ma-ath/Amplificador-de-Potencia/README.md

# Amplificador-de-Potencia
Trabalho Final de Eletrônica IV - Amplificador de Potência

エレクトロニクス4期末宿題、パワー増幅器
