ma-ath/Amplificador-de-Potencia/Proposta de Trabalho.pdf

### Proposta de Trabalho

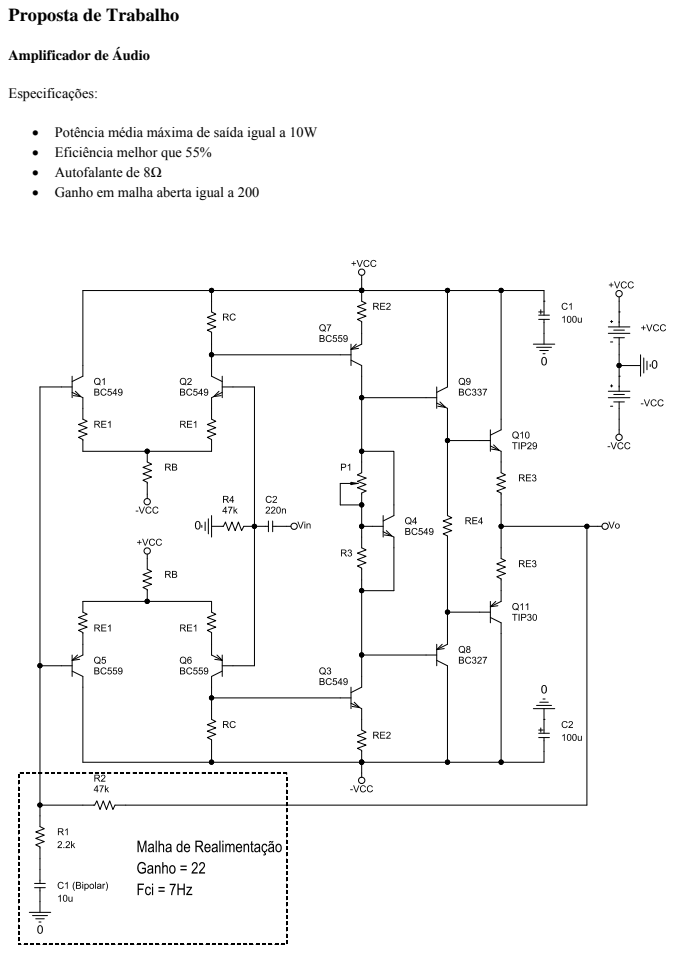
[picture p1: page 1]
Especificações:

Amplificador de Áudio

• Potência média máxima de saída igual a 10W
• Eficiência melhor que 55%
• Autofalante de 8Ω
• Ganho em malha aberta igual a 200

### Análise do Circuito

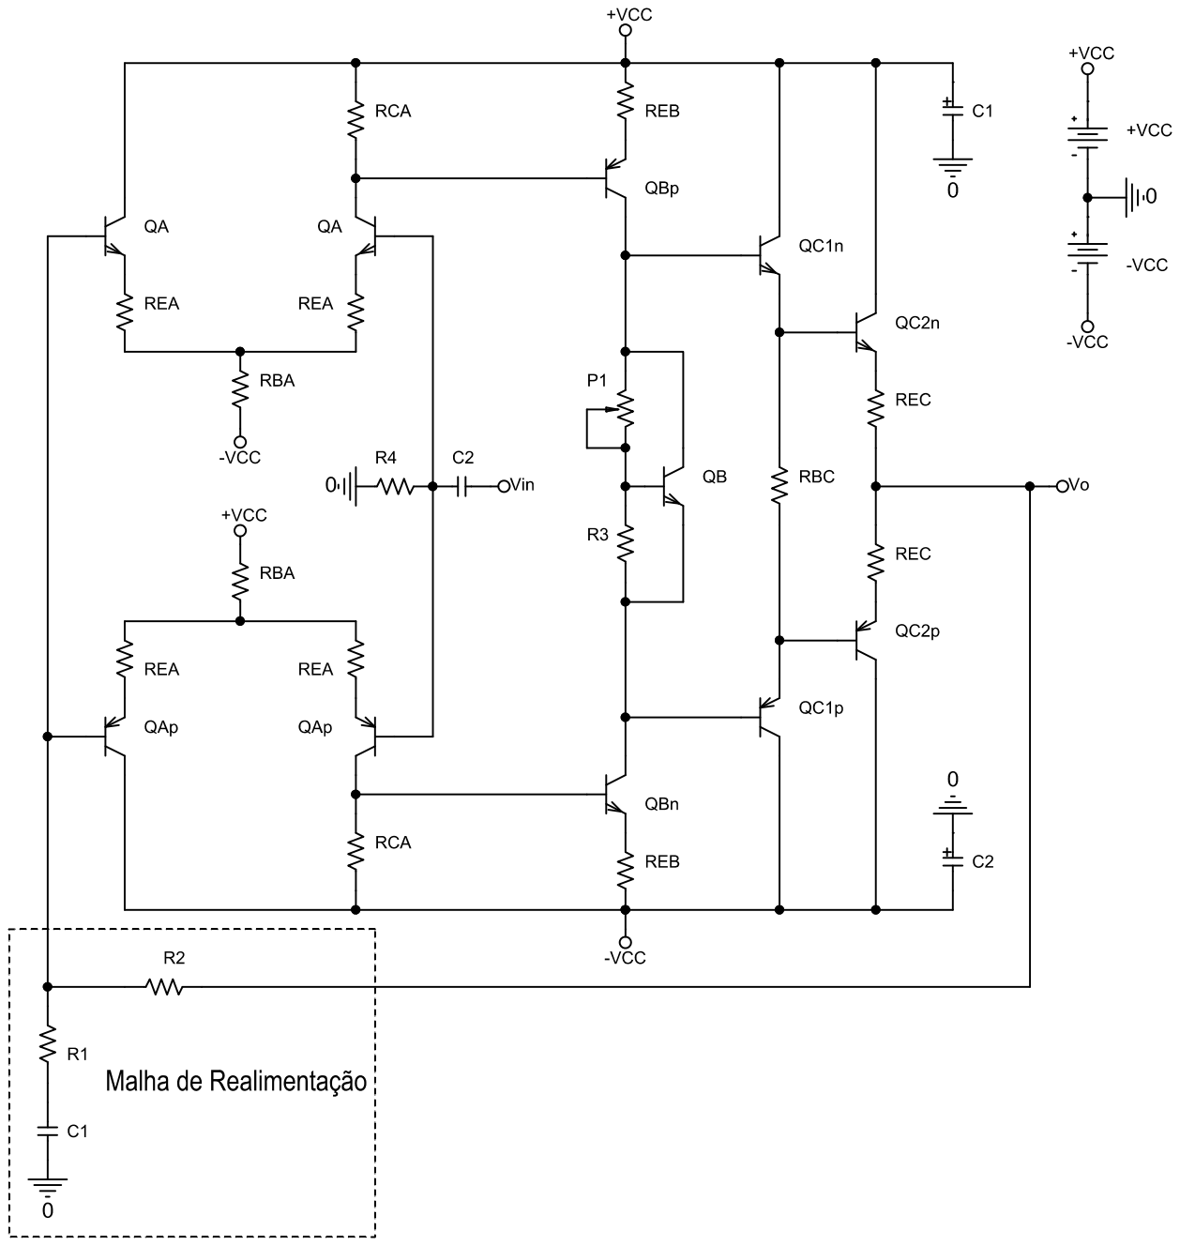
[picture p2: figure]

Figura 1: Amplificador de potência.

Inicialmente vamos separar o circuito em 3 blocos básicos: A, estágio de entrada; B, estágio intermediário; C, estágio de saída. O estágio de saída é um push-pull com transistores em configuração Darlington. Se considerarmos
REC | L R e o ganho aproximadamente igual a 1, podemos representa-lo como uma carga equivalente para o
estágio B; com valor RCeq | C | C | L = | + | + (β | β 1 | 2 1 | 1 )( | ) R , onde βC1 e βC2 são os ganhos de corrente dos transistores. Desta

forma, temos o circuito simplificado da Fig.3. Note que Vq é a tensão VBEq equivalente da configuração Darlington (a soma dos VBEs dos transistores). O ganho de tensão em malha aberta é dado pela multiplicação dos ganhos de cada estágio. Como o ganho de tensão do estágio de saída é aproximadamente igual a 1, temos que o ganho total e:

A | AA OL | A B = | (1)

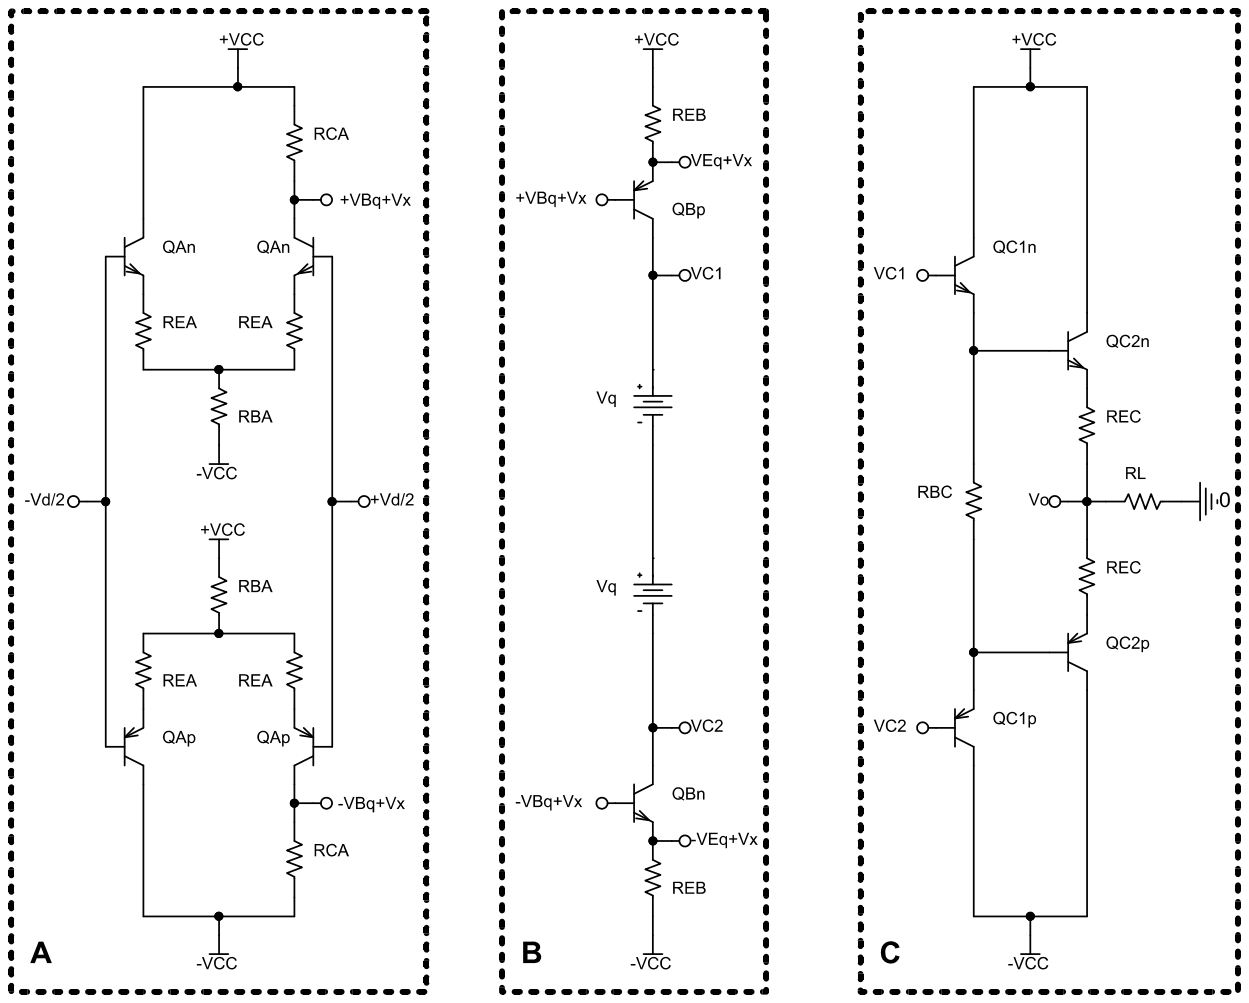
[picture p3: figure]

Figura 2: Amplificador de potência em blocos básicos.

Inicialmente vamos analisar o estágio B. Precisamos saber o valor da tensão de pico na saída V0MAX e a tensão de alimentação VCC. Podemos calcular V0MAX da especificação de potência máxima de saída, ou seja:

0 | 2 V | RP MAX | L LMAX = | (2)

A tensão de alimentação VCC pode ser calculada da especificação de eficiência máxima, ou seja:

0
4

MAX
CC
MAX

V V π
η
≤ | | | | | (3)

Voltando ao estágio B, temos que a tensão AC vx é proveniente da saída do estágio de entrada A. Esta tensão é responsável por gerar a corrente ic e a tensão de saída v0. A tensão AC em cada emissor é aproximadamente igual a
vx e, desta forma, ic pode ser dividida em duas partes iguais, uma para cada coletor, e dada por | 2 c | x | EB i | vR = - | .
Então, temos que:

0

2 Ceq

Ceq c | x | B | x
EB

R
v | R i | v | A | v
R = | =- | =- | (4)

Para estabelecer as condições de polarização adequadas para o funcionamento do circuito, vamos considerar somente a parte superior (o transistor PNP), pois devido à simetria podemos estender o resultado para a parte inferior. Ao passo em que a tensão vx varia, v0 e vC1 variam também. Mas não podemos permitir que a tensão entre emissor e coletor seja menor que VECsat, e nem que a tensão de emissor ultrapasse VCC, pois isto implicaria em uma

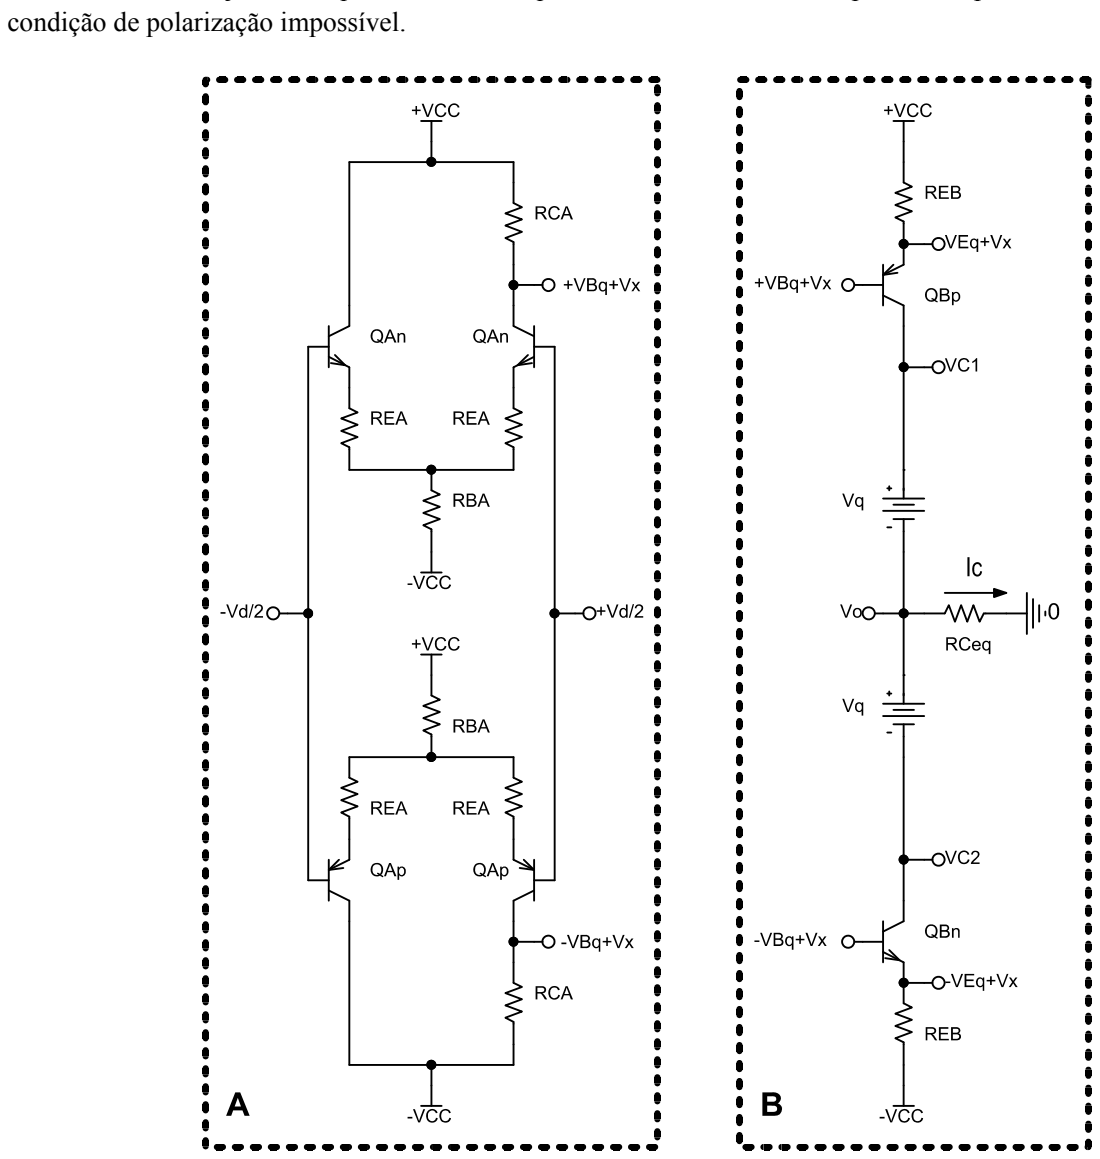
[picture p4: figure]
condição de polarização impossível.

Figura 3: Modelo simplificado.

Por inspeção, verificamos que C | q 1 | 0 v | Vv =+ e a tensão vEC dada por:
EC | Eq | x | C | Eq | x | q 1 | 0 v | V | vv | V | vvV = | +- | = | +-- | (5)

Substituindo (4) em (5), temos que

0
EC | Eq | q 0
B
v v | V | vV
A = | - | -- | (6)

A tensão entre emissor e coletor é mínima quando a tensão de saída v0 é máxima. Substituindo este resultado
em (6), e aplicando a condição EC | ECsat v | V≥ | , temos a inequação:

0

1 1 Eq | ECsat | q | MAX

B

V | V | V | V
A
| æ | ö
≥ | +++ ç | ÷
| è | ø

(7)

Já a tensão de emissor vE é aproximadamente V | v Eq | x + , e | x | 0 | B v | v | A =- | , ou, de forma melhor,
E | Eq | B 0 v | V | v | A = | - | . Notamos que vE é máxima quando v0 é mínima, e o valor mínimo de v0 é -V0MAX . Forçando a
condição E | CC v | V≤ | , temos que

0MAX
Eq CC
B

V V V
A
≤ | - | (8)

Da equação (4) podemos determinar o resistor REB, e das inequações (7) e (8), podemos escolher um valor para VEq dentro do intervalo.

2 Ceq

EB
B

R
R
A = | (9)
Assumindo que EqB | CqB I | I ≈ | , podemos determinar ICqB por:
( | )

2

CC | Eq | CC | Eq | B
CqB
EB | Ceq
V | V | V | V | A
I
R | R
- | - = | = | (10)
Passemos agora para o estágio de entrada A. Por inspeção, temos que V | V | V Bq | Eq | EBq = | - | . Portanto, a diferença de
potencial sobre o resistor RC é V | V | V CC | Eq | EBq - | + | . Neste ponto, temos a liberdade de escolher a corrente de
polarização ICqA dos transistores do estágio A. De posse desta corrente, temos que
CC | Eq | EBq
CA
| CqA
V | V | V
R
| I
- | + = | (11)

Devido à degeneração de emissor nos amplificadores diferenciais, o ganho AA do estágio de entrada é
aproximadamente igual a ( | ) / /( | ( | 1) | 2 RCA | ieB | B | EB | EA - | + | + h | R | R β | , e com este valor podemos calcular o resistor REA, que

é dado por:

/ /( | ( | 1)
2
CA | ieB | B | EB
EA
A
R | h | R R
A
+ β + = | (12)
Considerando EqA | CqA I | I ≈ | , a corrente através de RBA é igual a 2 CqA I , e a diferença de potencial sobre o mesmo
é igual a V | V | RI CC | BEqA | EA CqA - | - | . Temos então que
2 | 2 | 2
CC | BEqA | EA CqA | CC | BEqA | EA
BA
| CqA | | | CqA
V | V | RI | V | V | R R
I | I
- | - | - = | = | - | (13)

Com relação ao estágio de saída, os resistores REC são usados para garantir a estabilidade térmica. Para carga de 8Ω, normalmente usa-se valores entre 0.2Ω e 0.47Ω. O resistor RBC é usado para gerar uma pequena corrente de polarização em QC1n e QC1p, de forma a mantê-los numa região onde os βs estejam próximos do valor máximo. Em geral utiliza-se uma corrente de polarização na ordem de 1mA.

O multiplicador de VBE pode ser dimensionado com base nas equações abaixo, lembrando que neste caso o cálculo de Vq deve ser realizado considerando pouca corrente através dos transistores de saída.

1

3

2 | 1 | B q | BEq
P V | V
R
æ | | ö
=+ ç | ÷ è | ø
(14)

3

1
1 | 1
| 2

B

B

Q

CqB
BEq | q

R
I
V V

β +
æ | ö ç | ÷ -
è | ø
- (15)

3

BEqB

CqB

V
R
I
≥ | (16)

O ganho do amplificador realimentado é definido pela malha de realimentação, e é dado por:

2

1

1 V

R A
R
=+ | (17)

O capacitor C1 é calculado de forma que a frequência de corte seja pelo menos 10 vezes menor que a frequência de corte inferior do amplificador. A resistência que C1 enxerga é R1. O valor de C1 é dado por:

1
1

10

2 CI

C

π f R = | (18)

O resistor R4 é usado para polarizar as bases de QAn e QAp em zero. O capacitor C2 define a frequência de corte inferior, e é dado por:

2
4

1

2 CI

C

π f R = | (19)

Exemplo de Projeto

Como exemplo de projeto, vamos dimensionar um amplificador da Figura 1 com as seguintes especificações:

- Potência média máxima de saída igual a 20W
- Eficiência melhor que 50%
- Autofalante de 8Ω
- Ganho em malha aberta igual a 200
- Ganho de tensão realimentado igual a 18
- Frequência de corte inferior igual a 20Hz

Dados:

- Para os transistores BC549 e BC559, | 200 β = | e | 0.7 V | V BE | = | .
- Para os transistores BC327 e BC337, | 100 β = | , | 0.7 V | V BE | = | e | 0.5 V | V CEsat | ≈ | .
- Para os transistores TIP29 e TIP30, | 15 β = , | 0.7 @ | 10 V | V I | mA BE | C = | ≤ | e | 1@ | 1 V | VI | A BE | C = | ≥ .

Ao desenrolar dos cálculos, os valores dos componentes serão aproximados para os valores comerciais mais próximos.

Das equações (2) e (3), calculamos a tensão de pico na carga e a tensão de alimentação.

0 | 18 V | V MAX =

24 V | V CC =
Vamos adotar ganhos iguais para os estágios A e B, ou seja, | 200 14.1 A | A | A A | B | OL = | = | = | = | .

Segundo os dados do manual dos transistores potência, para corrente de coletor na ordem de 1A, temos
1 V | V BE | ≈ . Para os outros transistores adotaremos | 0.7 V | V BE | ≈ | . As tensões de saturação dos transistores QC1n e QC1p
são | 0.5 V | V CEsat | ≈ | .

Das inequações (7) e (8), determinamos o intervalo de escolha para VEq.

21.5 | 22.7 VV | V ≤ Eq ≤
Vamos adotar | 22 V | V Eq = | . Para RCeq temos RCeq = (100 1 15 1 8 13 + | + | = | Ω )( | ) | k , e pela equação (9) obtemos o

valor de REB.

1.8 REB = kΩ

Como temos a liberdade de atribuir a corrente de polarização do estágio de entrada, adotaremos | 1 CqA I | mA = | , e
pela equação (11) obtemos o valor de RCA.

2.2 RCA = kΩ

Para calcular REA, primeiro precisamos do valor de ICqB que, pela equação (10), é igual a 1.1mA. Com este
valor determinamos hieB pela fórmula | 4.73 ieB | B T | CqB h | VI | k = | = | Ω β | . Assim, pela equação (12), calculamos o valor de
REA.

68 REA = Ω

Da equação (13) obtemos o valor de RBA.

12 RBA = kΩ

O multiplicador de VBE é dimensionado pelas equações (14), (15) e (16). De (16) obtemos 3 R > | Ω 636 e de
(15) obtemos 3 R < | Ω 170k , onde escolhemos 3 R = 3.3kΩ . Finalmente de (14) obtemos 1P | k = | Ω 10 | .

3 R = 3.3kΩ

1P | k | k = | Ω→ | Ω 10 | potenciômetrode 22

Adotando o resistor 1 R = 2.2kΩ sugerido no esquema do amplificador; de (17), calculamos R2 para estabelecer o ganho realimentado de 18.

2 R = 37.4kΩ

Este valor deve ser exato, pois define o ganho realimentado. Pode-se usar um resistor de precisão, uma associação de resistores ou um trimpot.

O resistor RBC é calculado de forma a garantir uma pequena corrente de polarização em QC1n e QC1p, que
adotaremos aproximadamente igual a 1mA. A diferença de potencial sobre RCB é | 2 | 2 | 1.4 BEqC | BEqC n | p V | V | V + | = | . Então
temos | 1.4 1 | 1.4 RCB = | = | Ω m | k , que aproximaremos para o valor comercial mais próximo.

1.5 RCB = kΩ

Finalmente, os capacitores C1 e C2 são calculados pelas equações (18) e (19), assumindo a frequência de corte inferior igual a 20Hz.

1 C | F = 33µ
2 C | nF =180

Resultados de simulação

0 20 @ | 18 P | W | V | V L | MAX = | =
0 0.43% @ | 18 THD | V | V = | = MAX
0 58% @ | 18 η = | = V | V MAX

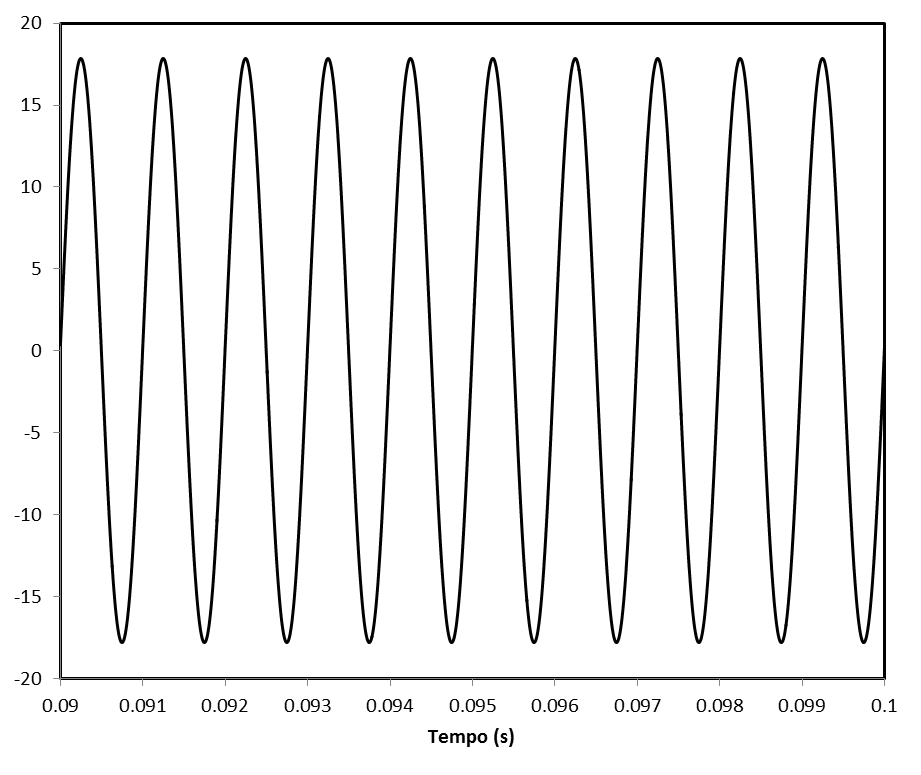
[picture p5: figure]

Figura 4: Gráfico da tensão de saída na frequência de 1kHz e amplitude de 18V.
