ma-ath/Amplificador-de-Potencia/PCB/pronto.pdf

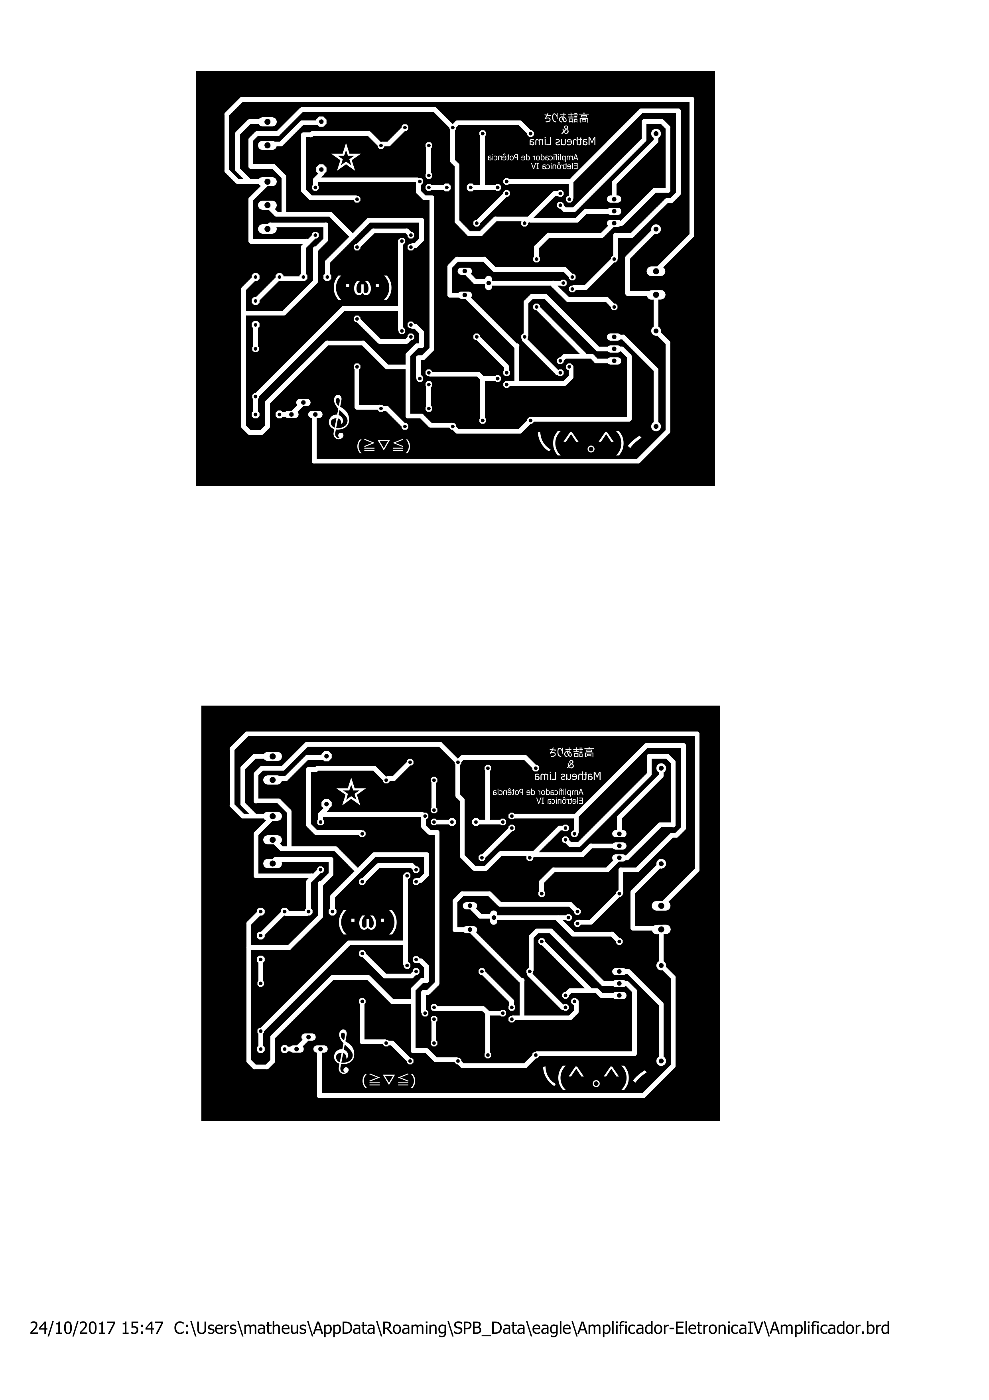
[picture p6: page 1]
