ma-ath/Amplificador-de-Potencia/eletronica-iv-trabalho-PSpiceFiles/Simulações/resposta-frequencia-temperatureSweap.pdf

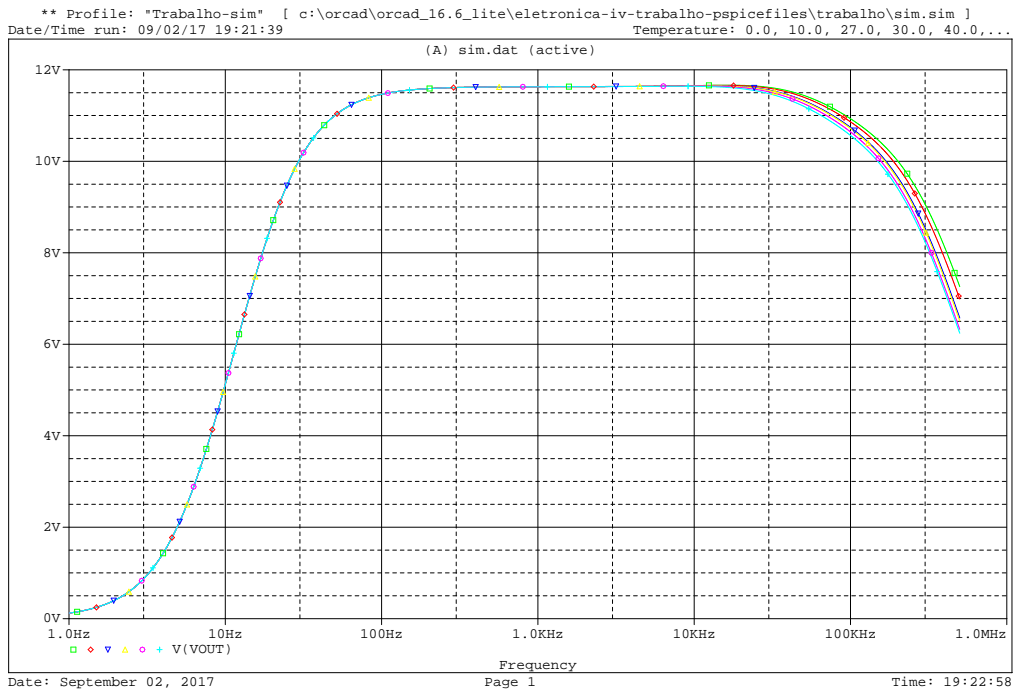
[picture p7: page 1]
Temperature: 0.0, 10.0, 27.0, 30.0, 40.0,...; Date: September 02, 2017; Page 1; Time: 19:22:58; Frequency; 1.0KHz; 10KHz; 100KHz; 1.0MHz; V(VOUT)

** Profile: "Trabalho-sim" [ c:\orcad\orcad_16.6_lite\eletronica-iv-trabalho-pspicefiles\trabalho\sim.sim ]
Date/Time run: 09/02/17 19:21:39

(A) sim.dat (active)
