ma-ath/Amplificador-de-Potencia/eletronica-iv-trabalho-PSpiceFiles/Simulações/resposta-frequencia.pdf

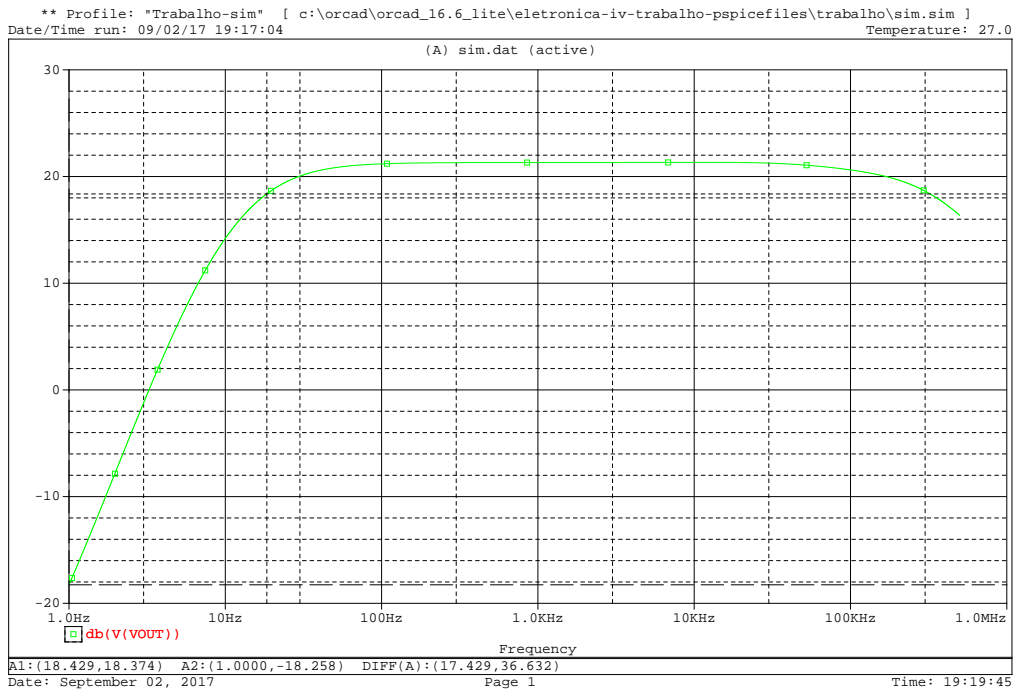
[picture p8: page 1]
A1:(18.429,18.374) A2:(1.0000,-18.258) DIFF(A):(17.429,36.632); Temperature: 27.0; Date: September 02, 2017; Page 1; Time: 19:19:45; Frequency; 1.0KHz; 10KHz; 100KHz; 1.0MHz; db(V(VOUT))

** Profile: "Trabalho-sim" [ c:\orcad\orcad_16.6_lite\eletronica-iv-trabalho-pspicefiles\trabalho\sim.sim ]
Date/Time run: 09/02/17 19:17:04

(A) sim.dat (active)
