ma-ath/Amplificador-de-Potencia/eletronica-iv-trabalho-PSpiceFiles/Simulações/transiente-10w-fourier.pdf

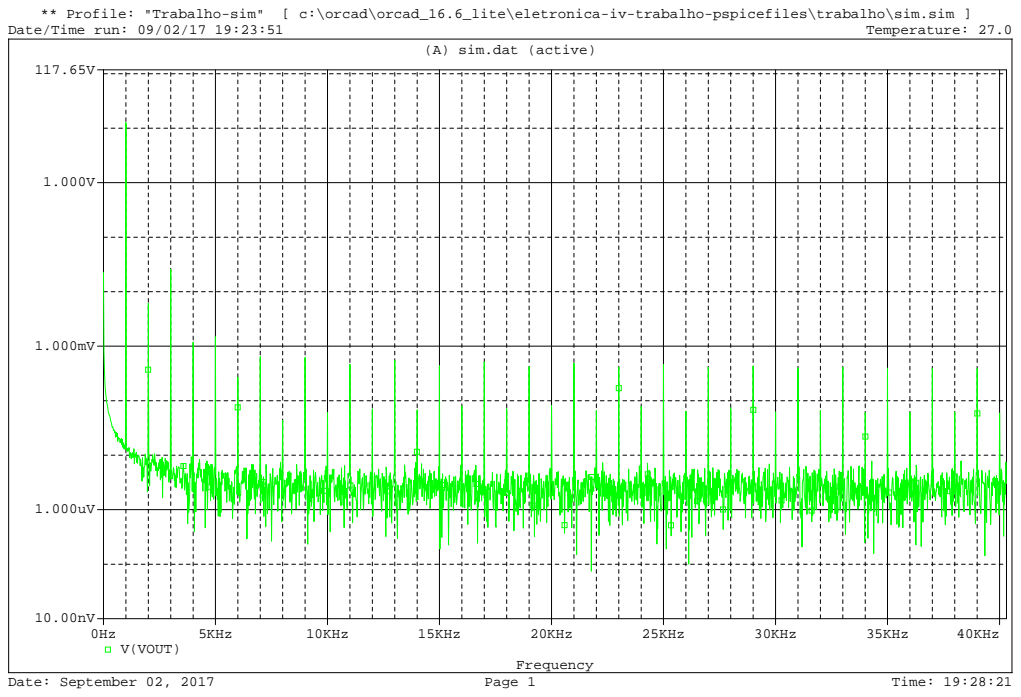
[picture p9: page 1]
Temperature: 27.0; Date: September 02, 2017; Page 1; Time: 19:28:21; Frequency; 5KHz; 10KHz; 15KHz; 20KHz; 25KHz; 30KHz; 35KHz; 40KHz; V(VOUT)

** Profile: "Trabalho-sim" [ c:\orcad\orcad_16.6_lite\eletronica-iv-trabalho-pspicefiles\trabalho\sim.sim ]
Date/Time run: 09/02/17 19:23:51

(A) sim.dat (active)
