ma-ath/Amplificador-de-Potencia/eletronica-iv-trabalho-PSpiceFiles/Simulações/transiente-10w.pdf

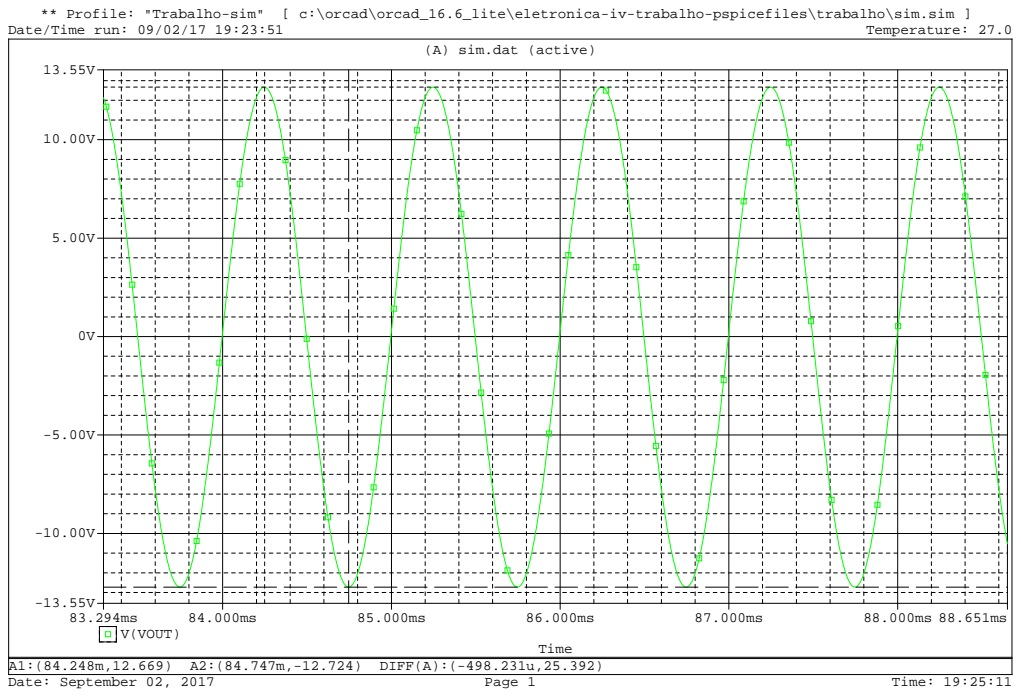
[picture p10: page 1]
A1:(84.248m,12.669) A2:(84.747m,-12.724) DIFF(A):(-498.231u,25.392); Temperature: 27.0; Date: September 02, 2017; Page 1; Time: 19:25:11; Time; V(VOUT)

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

(A) sim.dat (active)
