ma-ath/Amplificador-de-Potencia/eletronica-iv-trabalho-PSpiceFiles/Simulações/transiente-limite-de-excursao-fourier.pdf

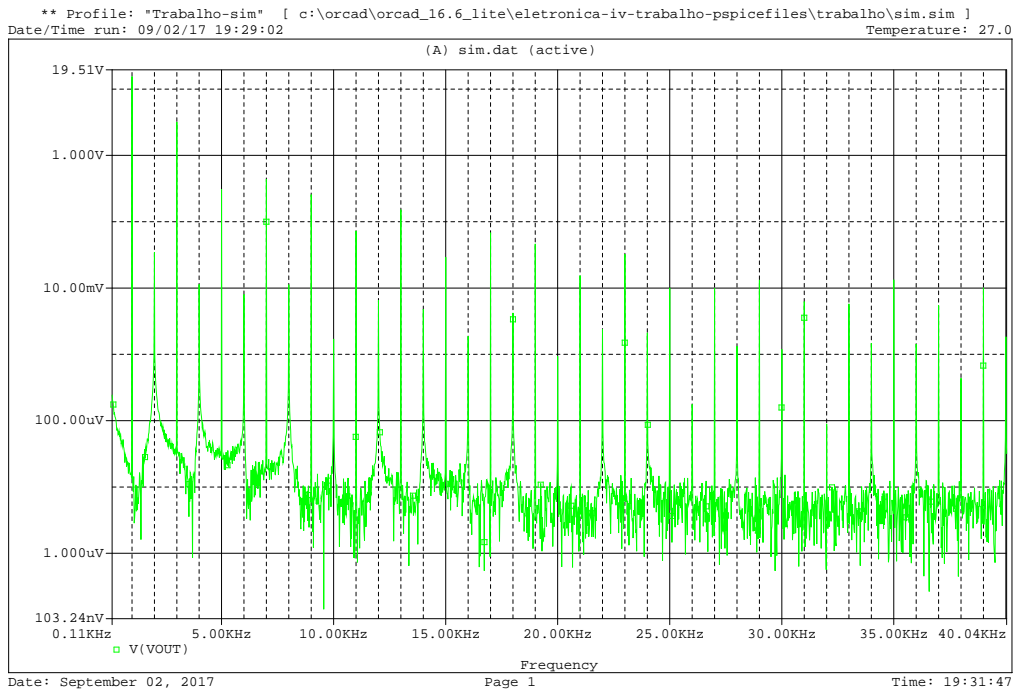
[picture p11: page 1]
Temperature: 27.0; Date: September 02, 2017; Page 1; Time: 19:31:47; Frequency; 0.11KHz; 5.00KHz; 10.00KHz; 15.00KHz; 20.00KHz; 25.00KHz; 30.00KHz; 35.00KHz 40.04KHz; V(VOUT)

** Profile: "Trabalho-sim" [ c:\orcad\orcad_16.6_lite\eletronica-iv-trabalho-pspicefiles\trabalho\sim.sim ]
Date/Time run: 09/02/17 19:29:02

(A) sim.dat (active)
