ma-ath/Amplificador-de-Potencia/eletronica-iv-trabalho-PSpiceFiles/Simulações/transiente-limite-de-excursao.pdf

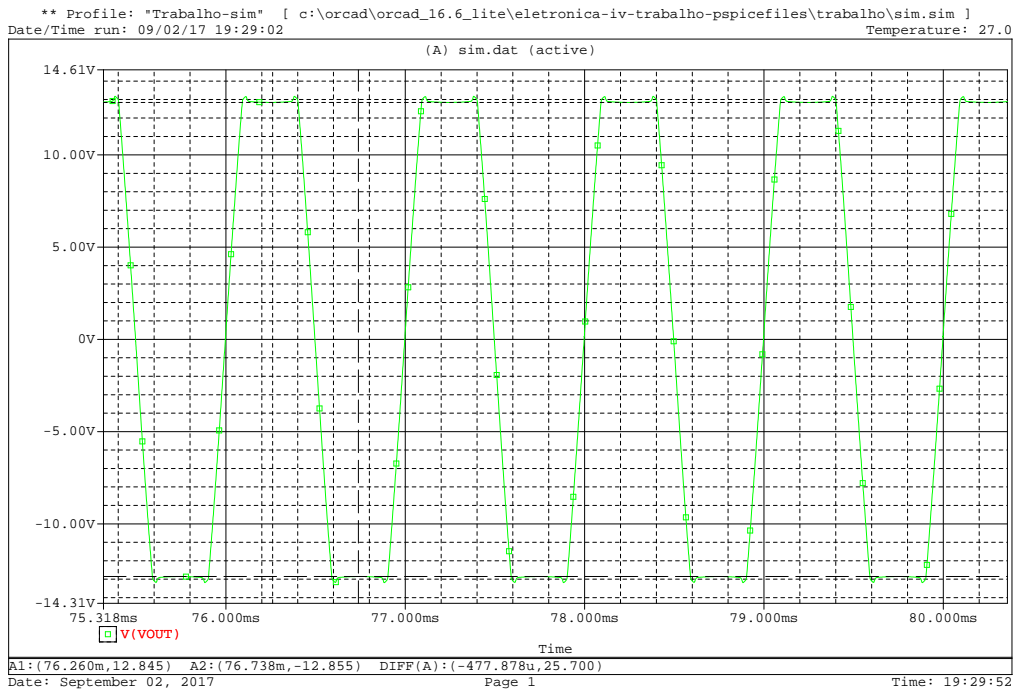
[picture p12: page 1]
A1:(76.260m,12.845) A2:(76.738m,-12.855) DIFF(A):(-477.878u,25.700); Temperature: 27.0; Date: September 02, 2017; Page 1; Time: 19:29:52; Time; V(VOUT)

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

(A) sim.dat (active)
