ma-ath/Amplificador-de-Potencia/PCB/PADS+Vias+INV.pdf

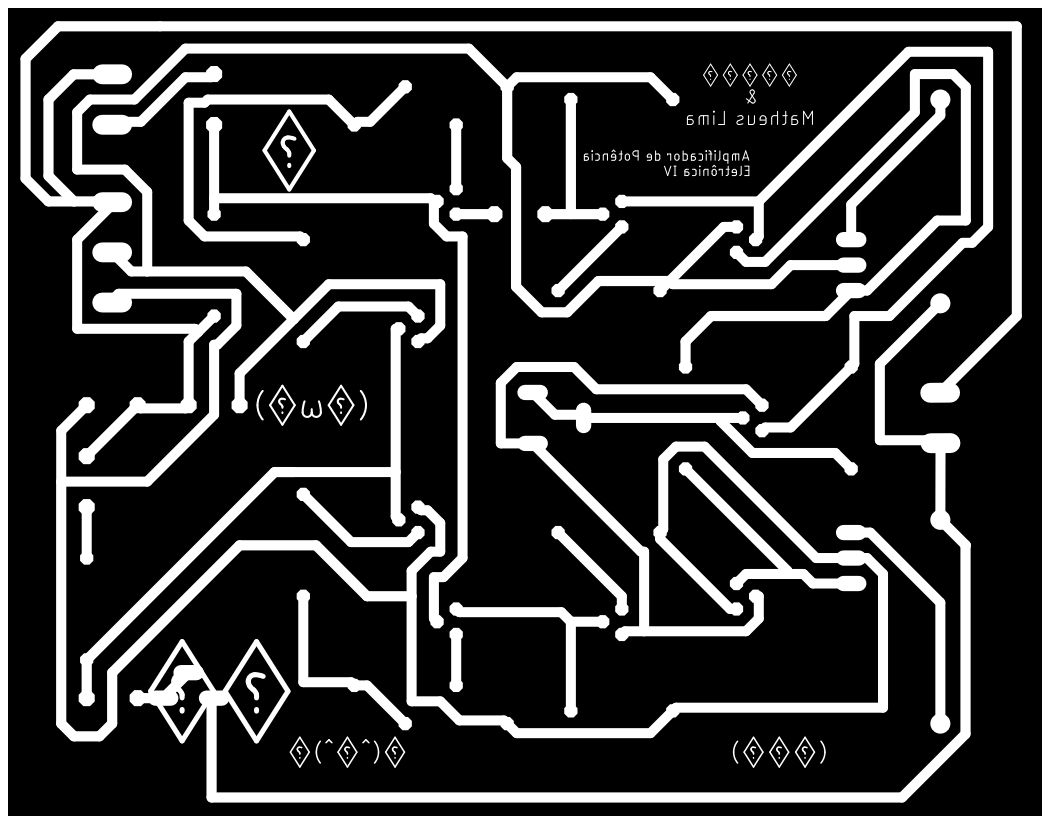
[picture p13: page 1]
