ma-ath/Amplificador-de-Potencia/PCB/LEGENDA.pdf

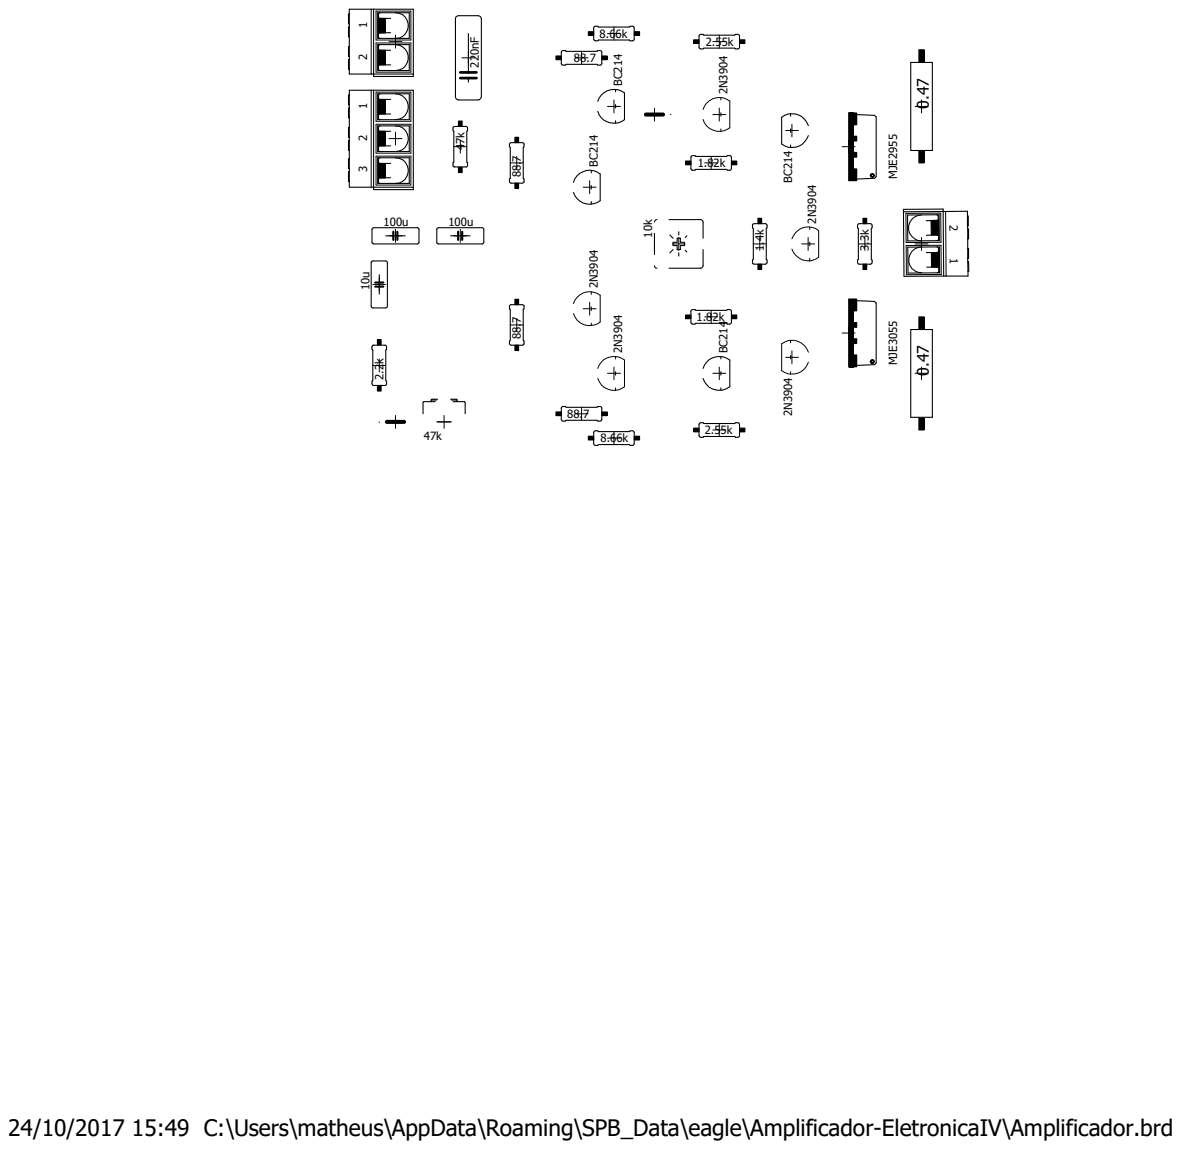
[picture p14: page 1]
MJE2955 MJE3055

24/10/2017 15:49 C:\Users\matheus\AppData\Roaming\SPB_Data\eagle\Amplificador-EletronicaIV\Amplificador.brd
