ma-ath/Amplificador-de-Potencia/PCB/MASCARA_DE_SOLDA.pdf

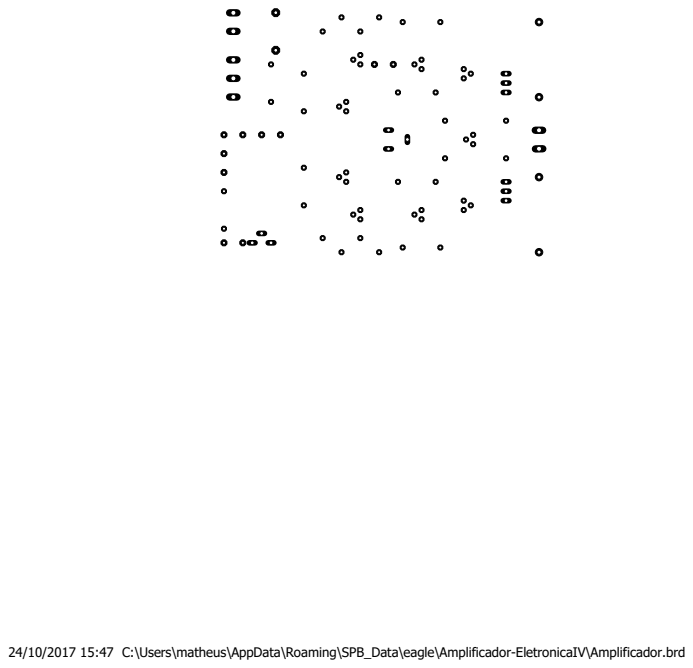
[picture p15: page 1]

24/10/2017 15:47 C:\Users\matheus\AppData\Roaming\SPB_Data\eagle\Amplificador-EletronicaIV\Amplificador.brd
