ma-ath/Amplificador-de-Potencia/PCB/PADS+Vias.pdf

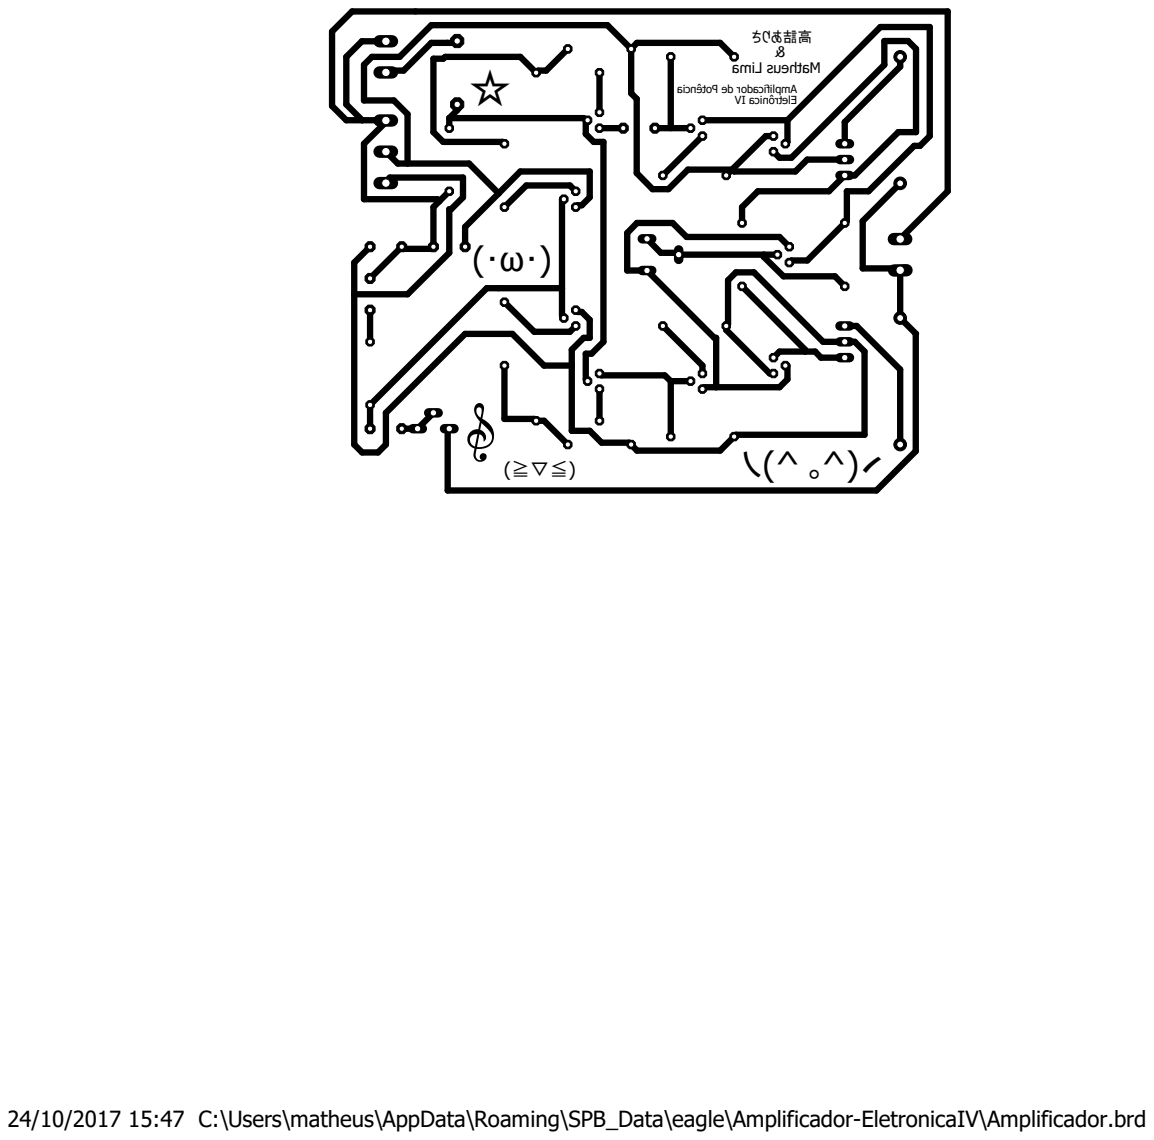
[picture p16: page 1]
高詰ありさ & Matheus Lima; Eletrônica IV

Amplificador de Potência

24/10/2017 15:47 C:\Users\matheus\AppData\Roaming\SPB_Data\eagle\Amplificador-EletronicaIV\Amplificador.brd
