ma-ath/Amplificador-de-Potencia/PCB/PCI.pdf

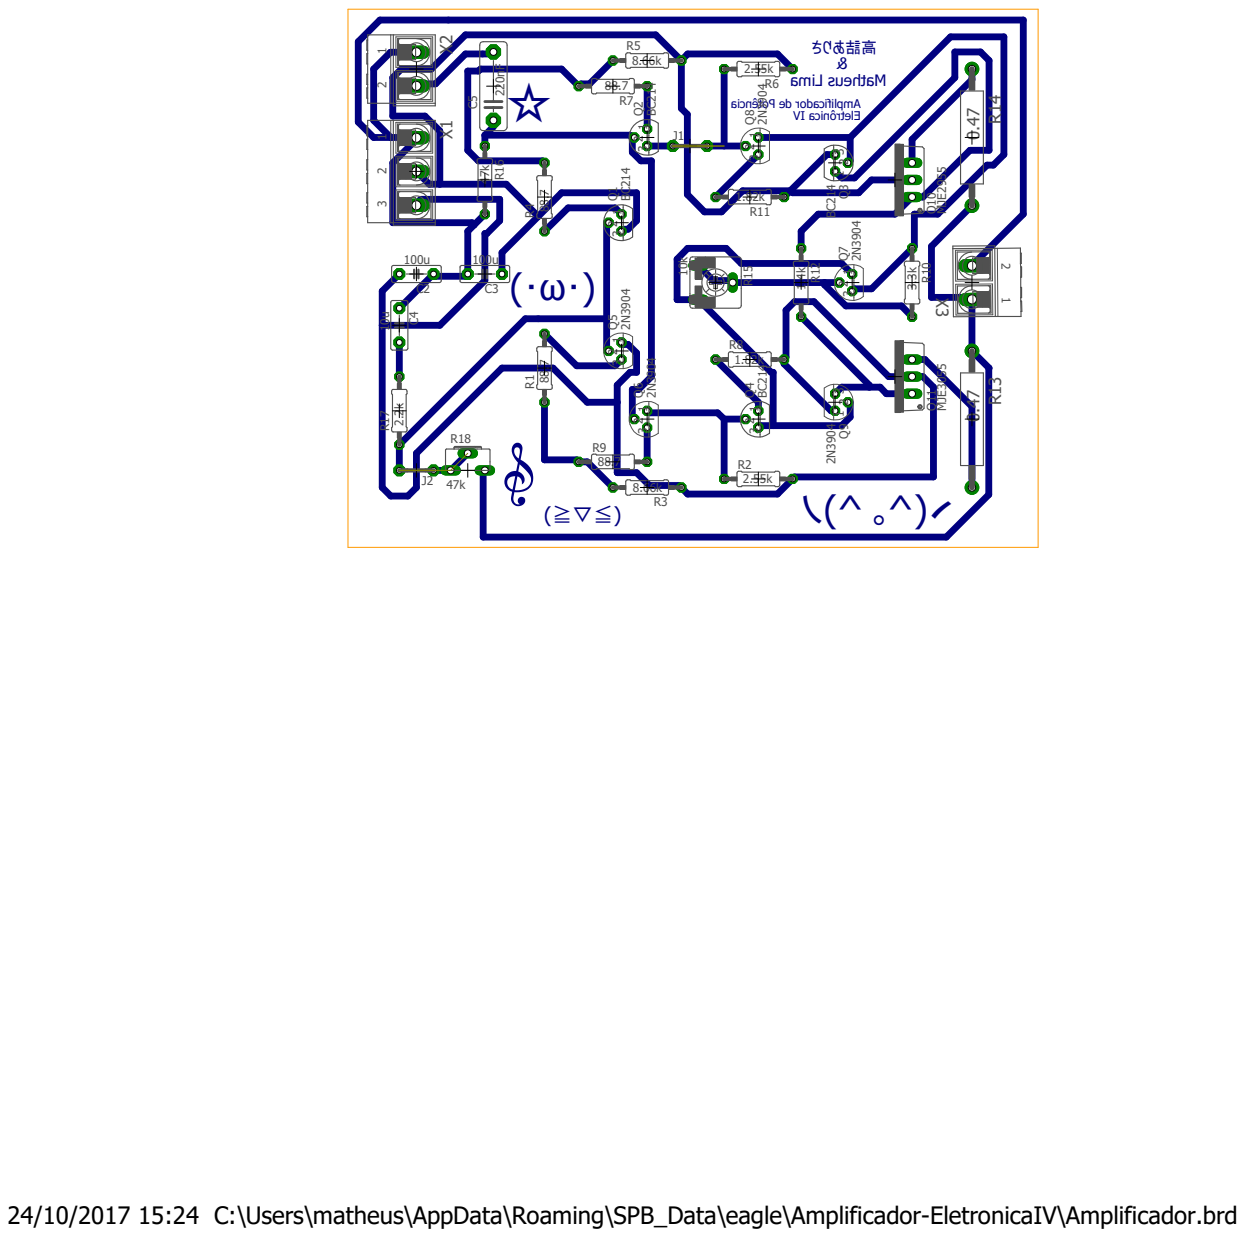
[picture p17: page 1]

24/10/2017 15:24 C:\Users\matheus\AppData\Roaming\SPB_Data\eagle\Amplificador-EletronicaIV\Amplificador.brd
