ma-ath/Amplificador-de-Potencia/eletronica-iv-trabalho-PSpiceFiles/Simulações/Trabalho _ Amplificador de Pote.pdf

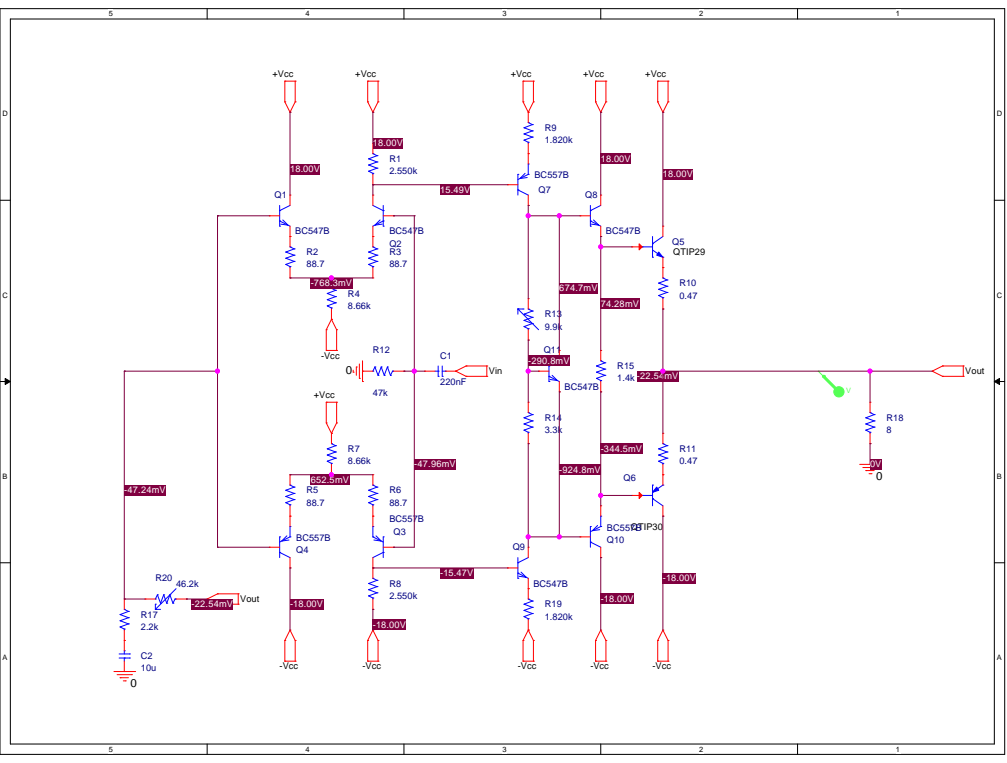
[picture p18: page 1]
