ma-ath/Amplificador-de-Potencia/PCB/Amplificador.brd

## EAGLE design PCB/Amplificador.brd (2017-10-10)

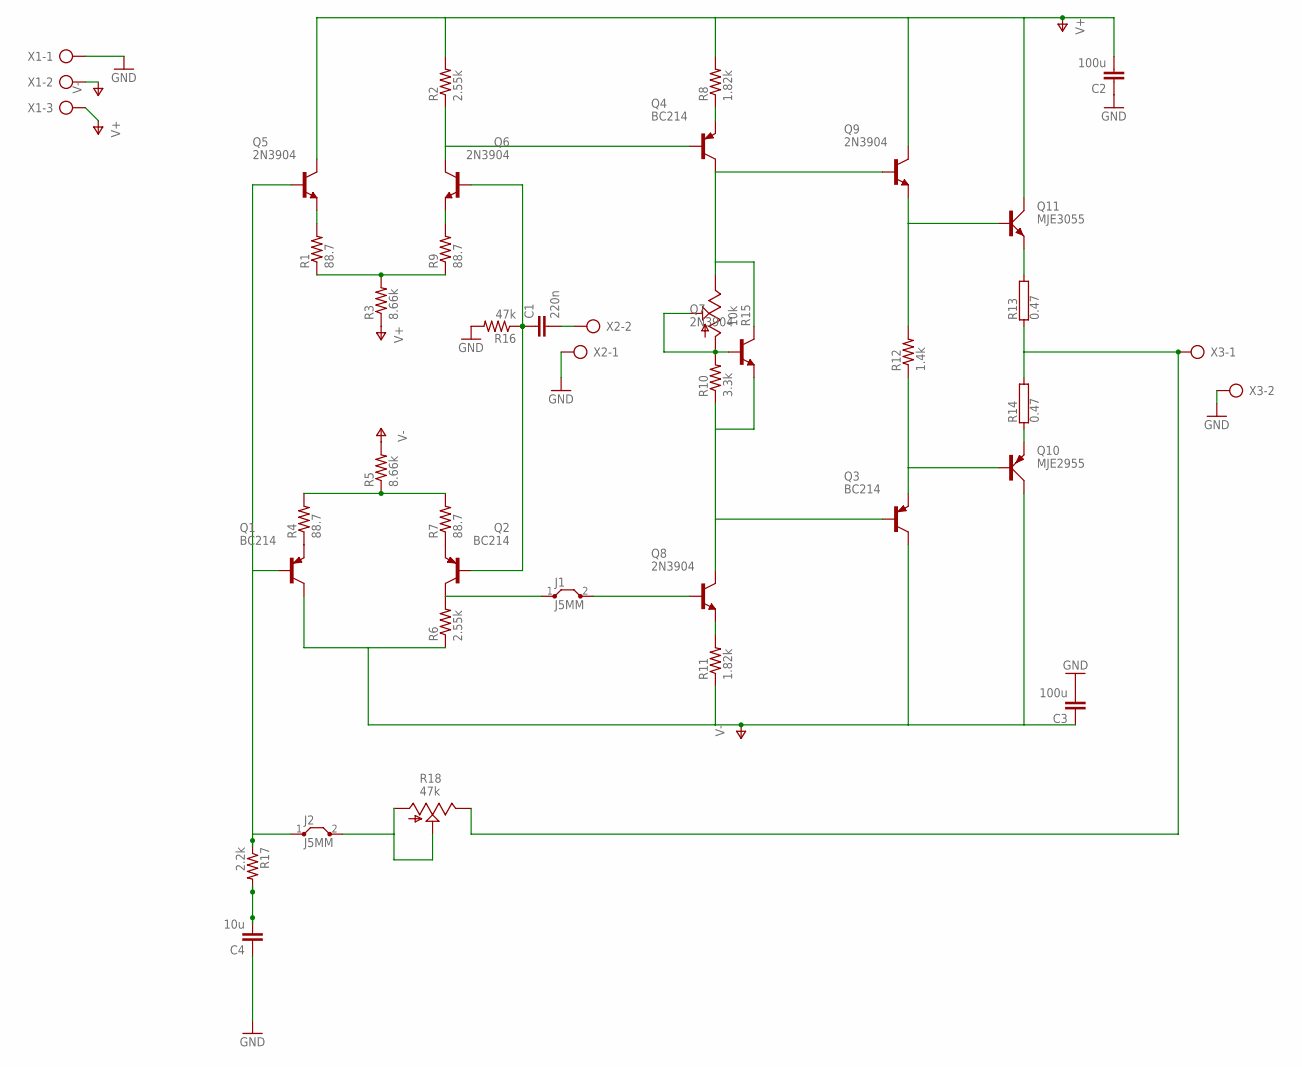
[picture p19: schematic Amplificador.sch]

Parts:
C1: 220n; C5B2.5
C2, C3: 100u; C5B2.5
C4: 10u; C5B2.5
J1, J2: J5MM; 05
Q1, Q2, Q3, Q4: BC214; TO92
Q5, Q6, Q7, Q8, Q9: 2N3904; TO92
Q10: MJE2955; TO220AV
Q11: MJE3055; TO220AV
R1, R4, R7, R9: 88.7; 0207/10
R2, R6: 2.55k; 0207/10
R3, R5: 8.66k; 0207/10
R8, R11: 1.82k; 0207/10
R10: 3.3k; 0207/10
R12: 1.4k; 0207/10
R13, R14: 0.47; CA4055
R15: 10k; CA6V
R16: 47k; 0207/10
R17: 2.2k; 0207/10
R18: 47k; CA6H
X1: AK500/3-H
X2, X3: AK500/2-H

Connections:
GND: C2.1, C3.2, C4.1, R16.2, X1.1, X2.1, X3.2
unnamed: R4.2, R5.1, R7.2
unnamed: J1.2, Q8.2 (B)
unnamed: Q3.1 (E), Q10.B, R12.1
unnamed: Q5.3 (E), R1.2
unnamed: Q4.2 (B), Q6.1 (C), R2.1
unnamed: Q8.3 (E), R11.2
unnamed: Q4.3 (C), Q7.1 (C), Q9.2 (B), R15.E
unnamed: Q7.2 (B), R10.2, R15.A, R15.S
unnamed: R1.1, R3.2, R9.1
unnamed: Q6.3 (E), R9.2
unnamed: Q1.1 (E), R4.1
unnamed: Q2.1 (E), R7.1
unnamed: C1.2, X2.2
unnamed: C1.1, Q2.2 (B), Q6.2 (B), R16.1
unnamed: R13.1, R14.2, R18.E, X3.1
unnamed: Q3.2 (B), Q7.3 (E), Q8.1 (C), R10.1
unnamed: Q4.1 (E), R8.1
unnamed: C4.2, R17.2
unnamed: J2.2, R18.A, R18.S
unnamed: Q9.3 (E), Q11.B, R12.2
unnamed: Q11.E, R13.2
unnamed: Q10.E, R14.1
unnamed: J1.1, Q2.3 (C), R6.2
unnamed: J2.1, Q1.2 (B), Q5.2 (B), R17.1
V+: C2.2, Q5.1 (C), Q9.1 (C), Q11.C, R2.2, R3.1, R8.2, X1.3
V-: C3.1, Q1.3 (C), Q3.3 (C), Q10.C, R5.2, R6.1, R11.1, X1.2

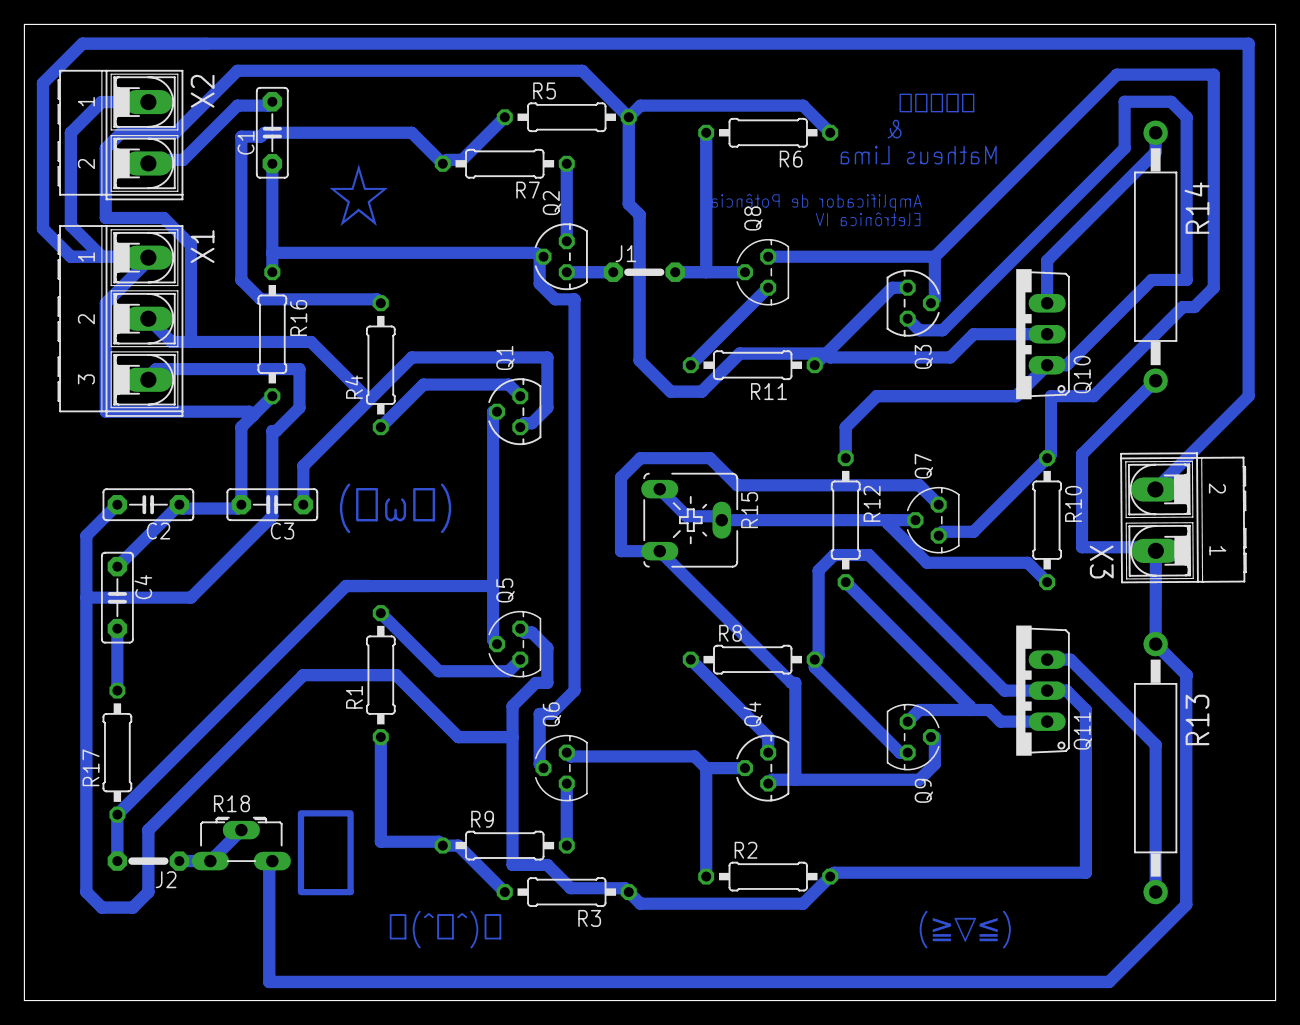
[picture p20: board Amplificador.brd from above]

Board: 2 copper layers, 102.5 x 80.0 mm, 38 parts (0 on the bottom side), 27 nets.
