ma-ath/Amplificador-de-Potencia/(commit log)

2017-10-08 Arquivos Amplificador de Potência
    Criado o repositório, e adicionado todos os arquivos até então criados para o trabalho do Amplificador de Potência - Eletrônica IV
    [Amplificador.brd, Amplificador.sch]
2017-10-08 Mudada a PCB
    Adicionado Nomes e Carinhas na PCB!
    [Amplificador.brd]
2017-10-10 Placa Versão 2.0
    Talvez a versão final, compatível com nossos componentes comprados
    [Amplificador.brd, Amplificador.sch]
2017-10-10 Trabalho de eletrônica versão 2.1
    Agora sim talvez a versão final, a anterior estava com erro
    [Amplificador.brd, Amplificador.sch]
2017-10-24 Amplificador Final!
    PCI Final + PDFs para impressao
